smlaage/GewitterMonitor_v3/PCB/Antenna-Board/Front-View.png

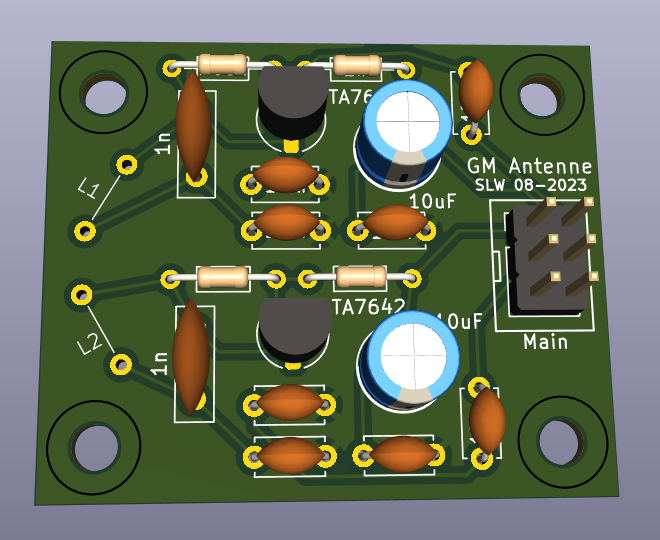
PCB/Antenna-Board/Front-View.png
