smlaage/GewitterMonitor_v3/GewitterMonitor_v3_Antenna_Schema.pdf

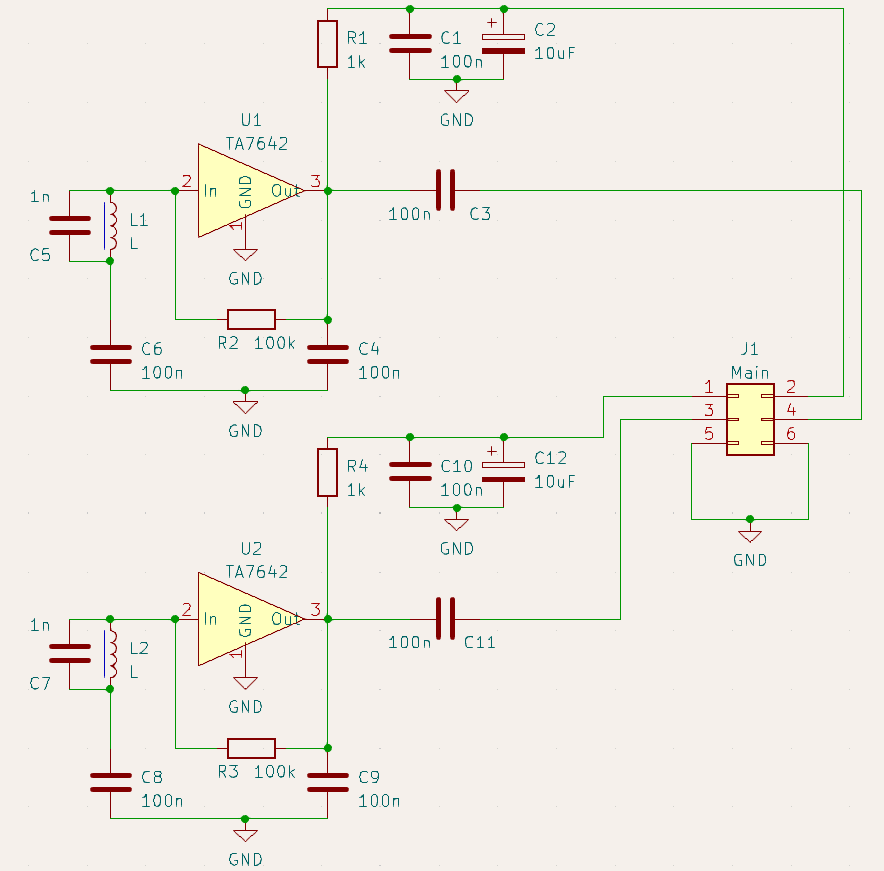
[picture p2: page 1]
