smlaage/GewitterMonitor_v3/PCB/Antenna-Board/Antenna-Module-1.png

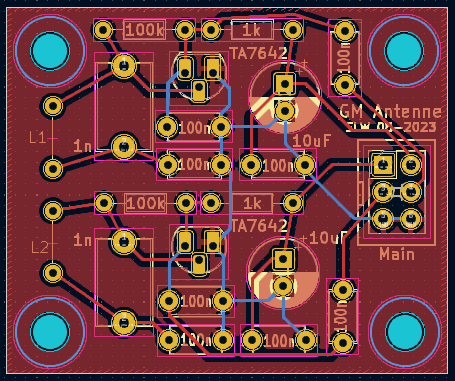
PCB/Antenna-Board/Antenna-Module-1.png
