smlaage/GewitterMonitor_v3/PCB/Antenna-Board/Antenna-Module-2.png

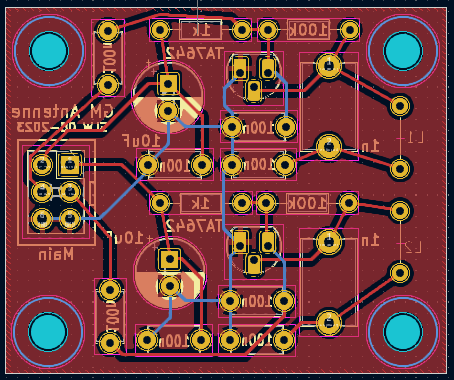
PCB/Antenna-Board/Antenna-Module-2.png
