smlaage/GewitterMonitor_v3/PCB/Main-Board/MainBoard-Back.png

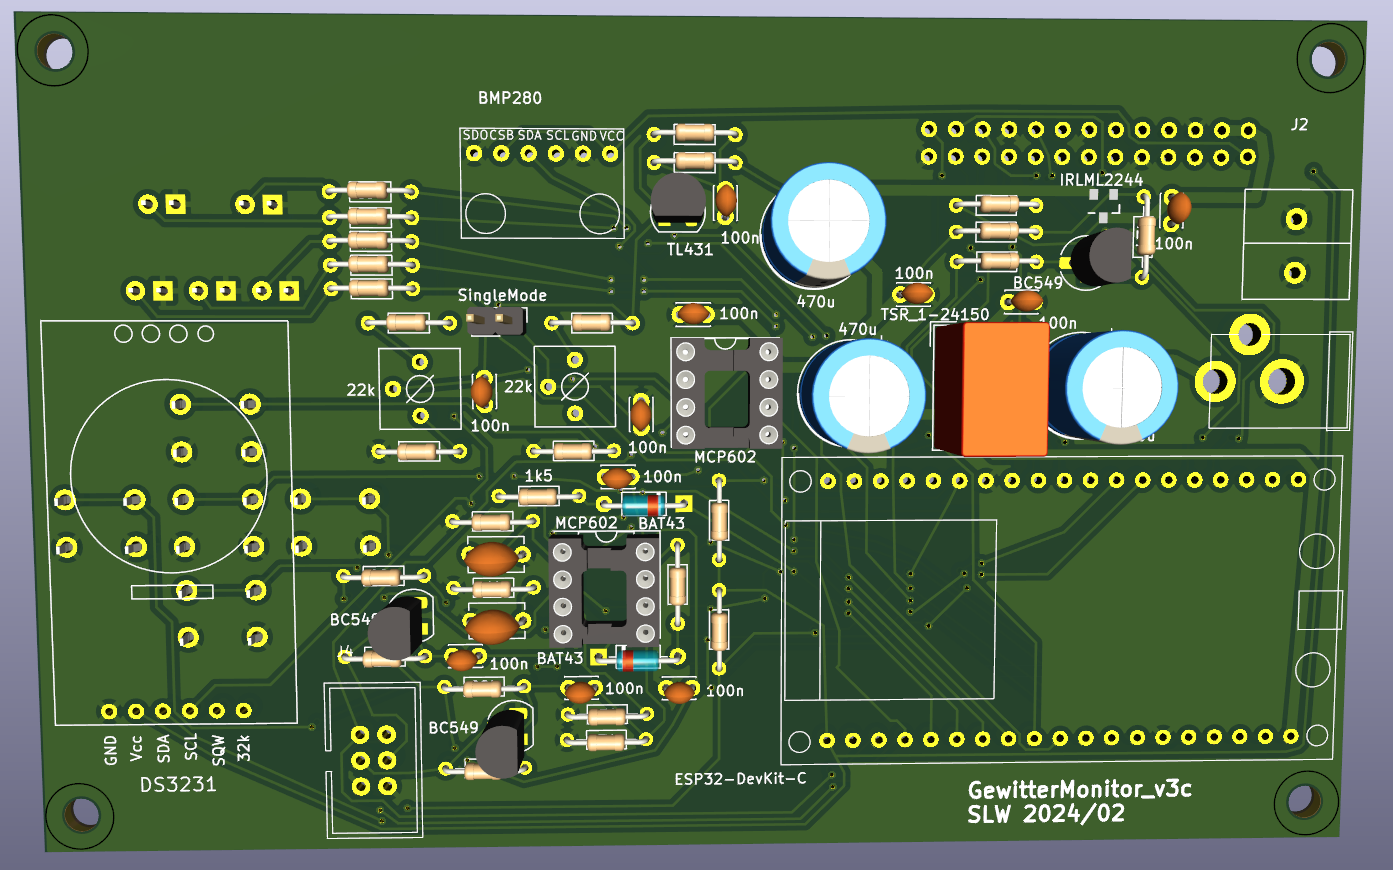
PCB/Main-Board/MainBoard-Back.png
