smlaage/GewitterMonitor_v3/PCB/Main-Board/MainBoard-Front.png

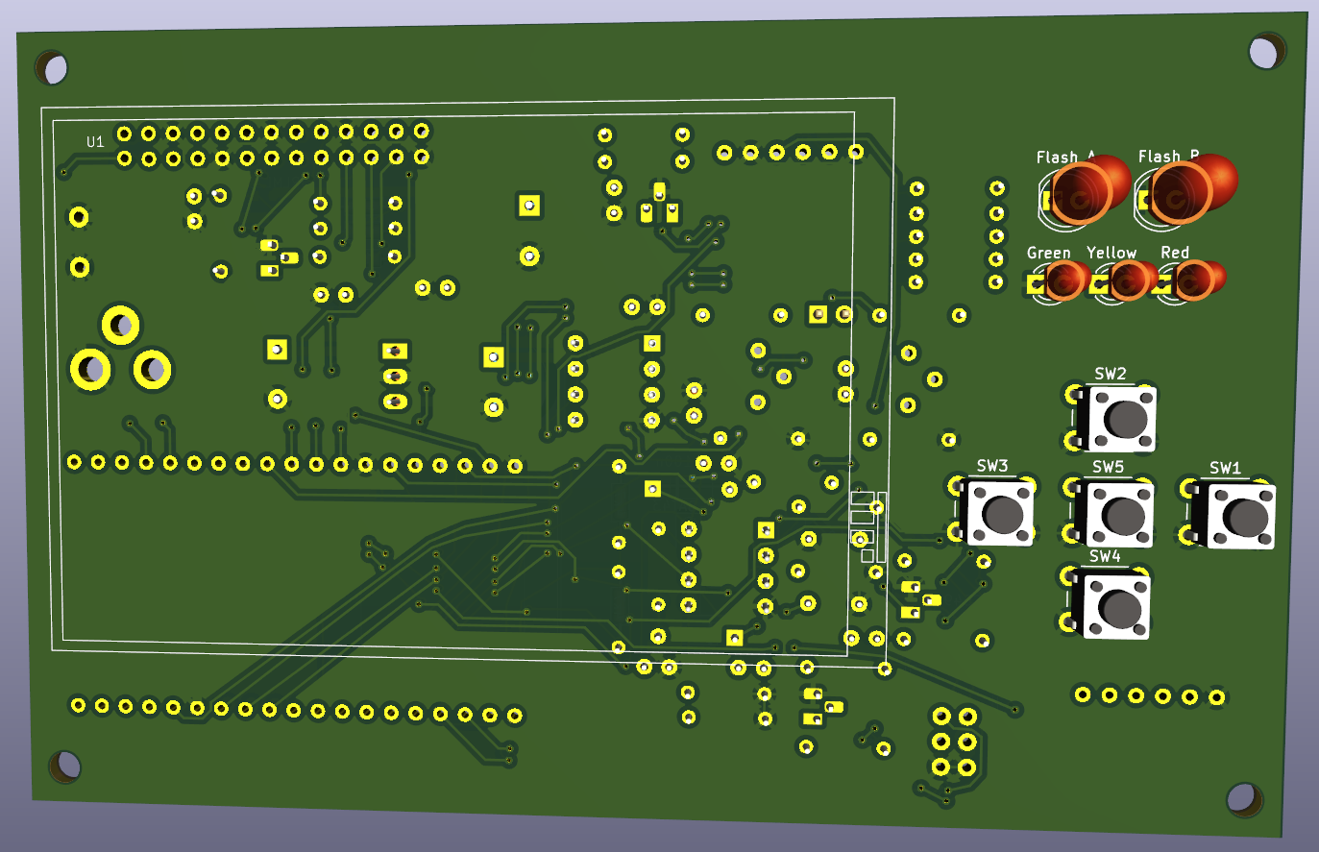
PCB/Main-Board/MainBoard-Front.png
