smlaage/GewitterMonitor_v3/3D-Printing/Standfuss.stl

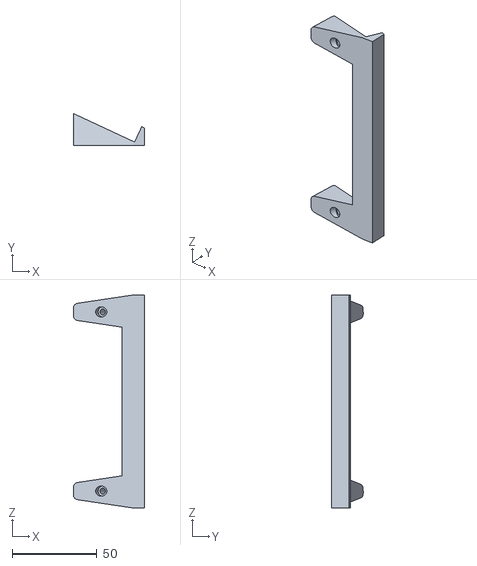
[picture p7: CAD file, 2024-04-09]
3D-Printing/Standfuss.stl
42.3 x 18.8 x 126.0
