smlaage/GewitterMonitor_v3/3D-Printing/LED-Abstandshalter.stl

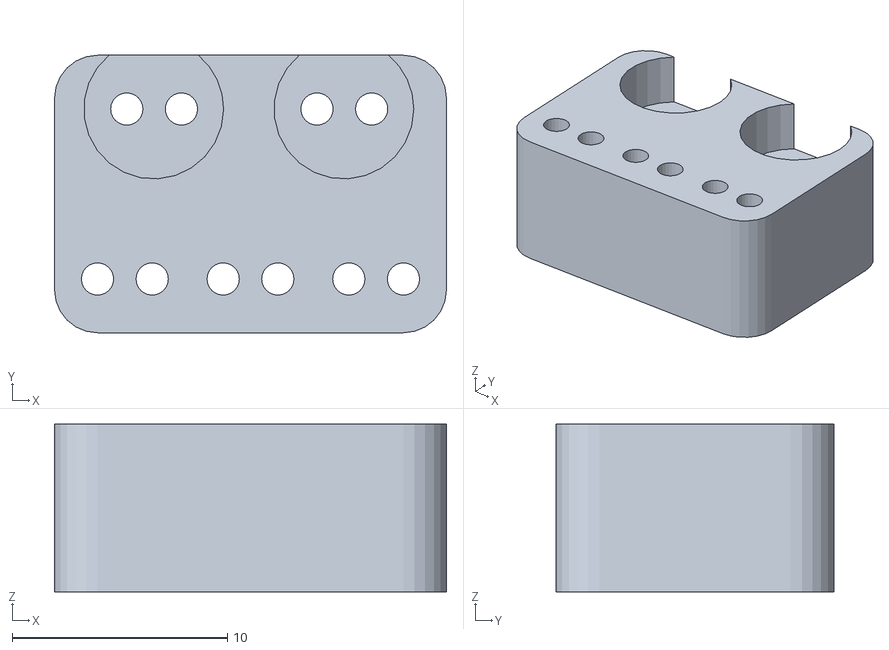
[picture p8: CAD file, 2024-04-09]
3D-Printing/LED-Abstandshalter.stl
18.2 x 12.9 x 7.80
