smlaage/GewitterMonitor_v3/3D-Printing/Antennenhalter.stl

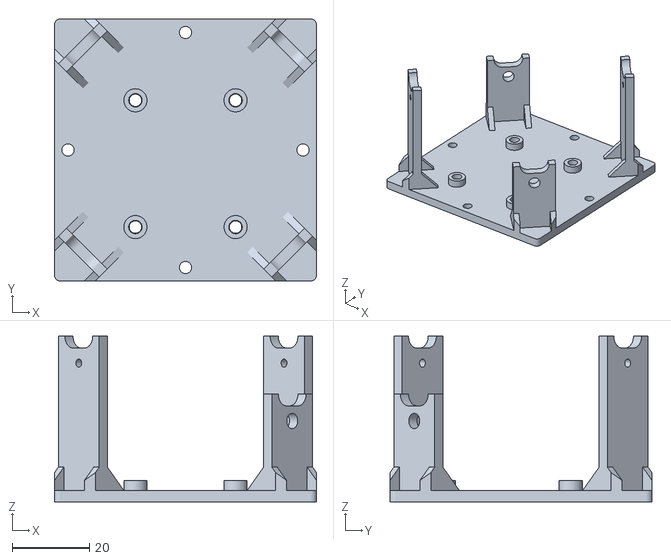
[picture p9: CAD file, 2023-09-27]
3D-Printing/Antennenhalter.stl
68.0 x 68.0 x 43.0
