smlaage/GewitterMonitor_v3/3D-Printing/Display-Spacer.stl

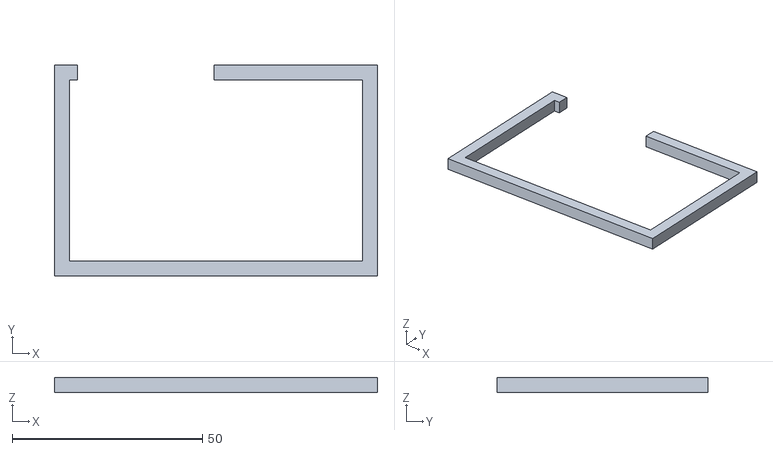
[picture p10: CAD file, 2023-09-27]
3D-Printing/Display-Spacer.stl
85.0 x 55.5 x 4.00
