smlaage/GewitterMonitor_v3/3D-Printing/Display-Rahmen.stl

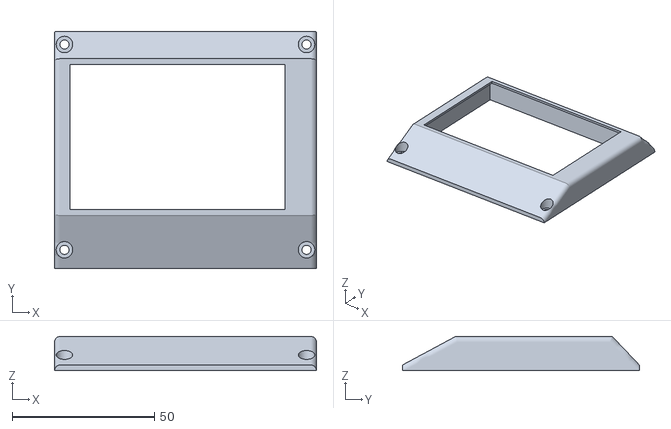
[picture p11: CAD file, 2023-09-27]
3D-Printing/Display-Rahmen.stl
92.0 x 83.1 x 12.0
