smlaage/GewitterMonitor_v3/3D-Printing/Frontplatte.stl

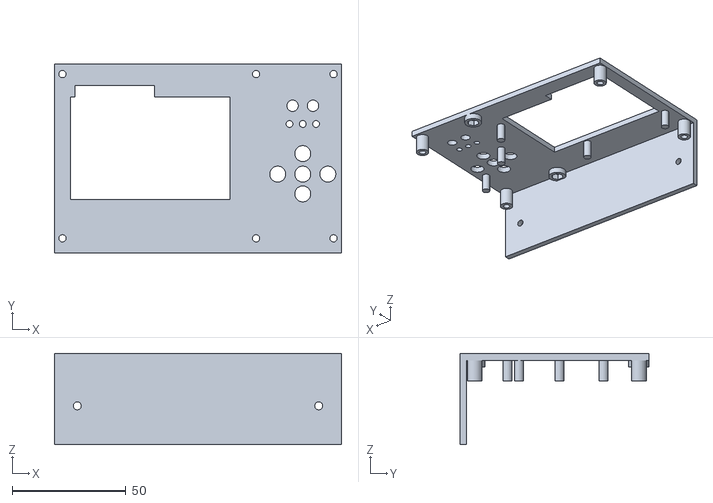
[picture p12: CAD file, 2023-09-27]
3D-Printing/Frontplatte.stl
126.0 x 83.1 x 40.0
