smlaage/GewitterMonitor_v3/GewitterMonitor_v3_Main_Schema.pdf

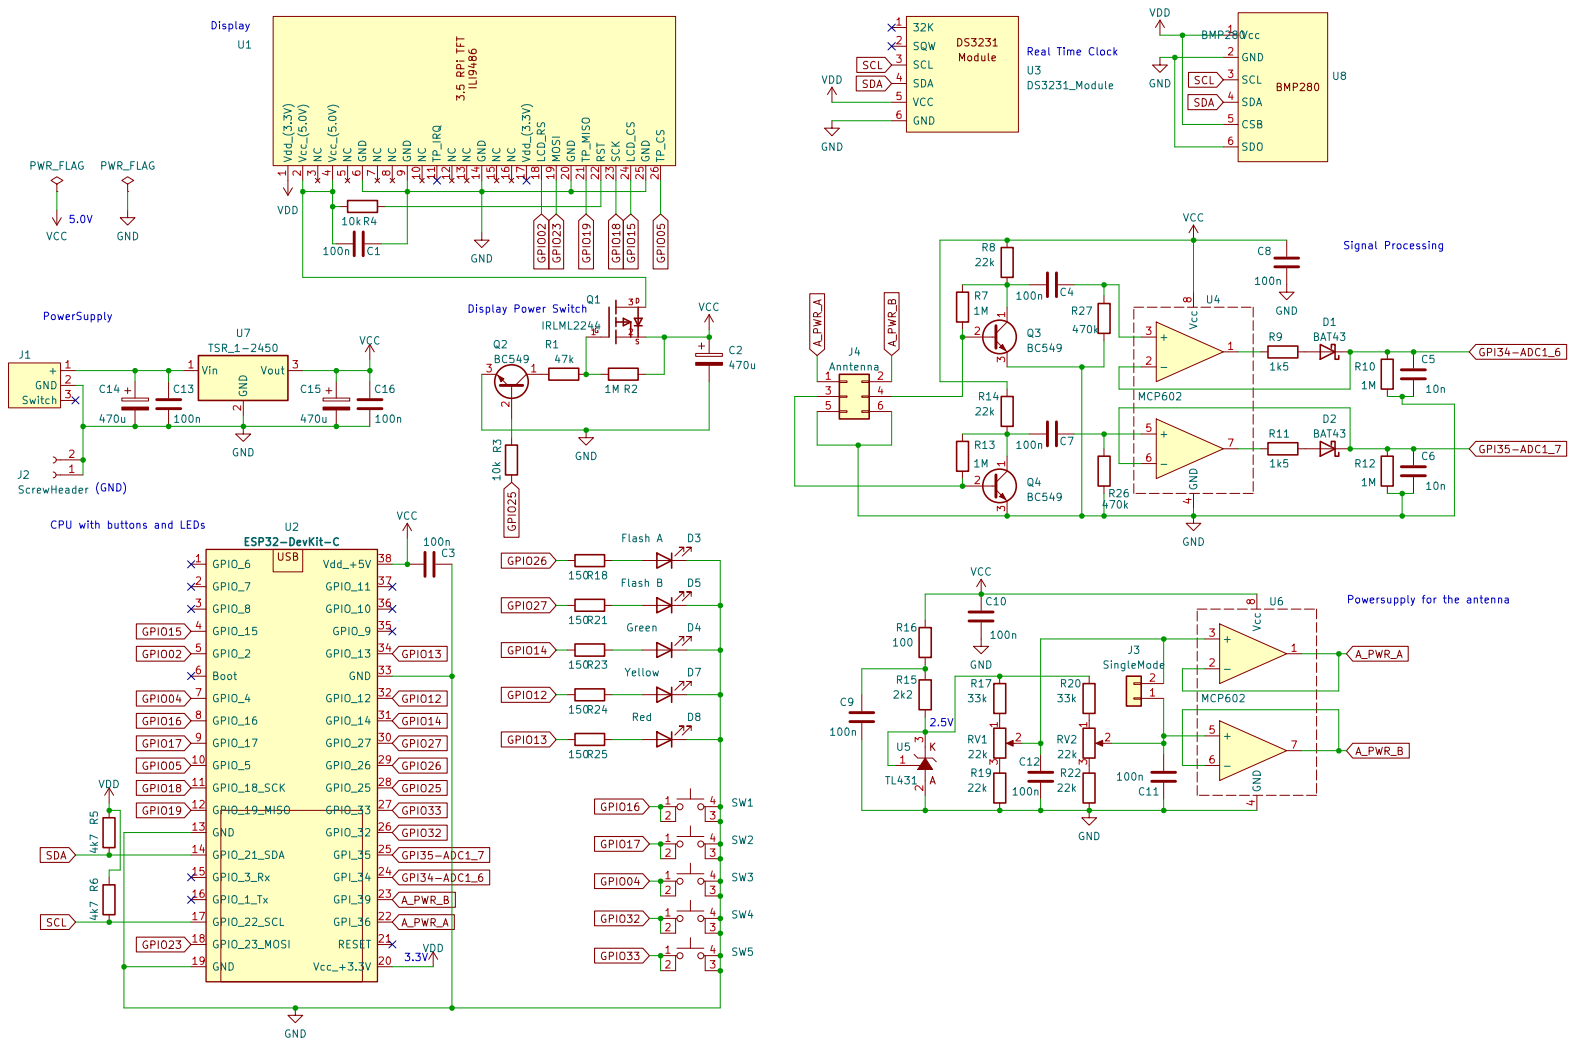
[picture p13: page 1]
