smlaage/GewitterMonitor_v3/(commit log)

2023-09-27 PCB files added
    [GewitterMonitor-B_Cu.gbr, GewitterMonitor-B_Mask.gbr, GewitterMonitor-B_Paste.gbr, GewitterMonitor-B_Silkscreen.gbr, GewitterMonitor-Edge_Cuts.gbr, GewitterMonitor-F_Cu.gbr, GewitterMonitor-F_Mask.gbr, GewitterMonitor-F_Paste.gbr]
2023-09-27 Stl files added
    [Antennenhalter.stl, Display-Rahmen.stl, Display-Spacer.stl, Frontplatte.stl]
2023-10-04 Software Updates
    [Frontplatte.3mf]
2024-02-15 Schemas and part list added
    [GewitterMonitor_v3_PartList.xlsx]
2024-04-18 Schema labels fixed
    [GewitterMonitor_v3_PartList.csv, GewitterMonitor_v3_PartList.xlsx]
2024-04-18 PCB labels fixed
    [GewitterMonitor-B_Mask.gbr, GewitterMonitor-B_Paste.gbr, GewitterMonitor-B_Silkscreen.gbr, GewitterMonitor-Edge_Cuts.gbr, GewitterMonitor-F_Cu.gbr, GewitterMonitor-F_Mask.gbr, GewitterMonitor-F_Paste.gbr, GewitterMonitor-F_Silkscreen.gbr]
2024-05-19 Bug fix: air pressure sensor data
    [display.cpp]
2024-07-21 New version 3.2
    Based on Espressif 3.0.2
    WLAN and MQTT connectivity added
    [mqtt_config.txt]
2024-07-21 PCB bug fixes
    [GewitterMonitor-B_Cu.gbr, GewitterMonitor-B_Mask.gbr, GewitterMonitor-B_Paste.gbr, GewitterMonitor-B_Silkscreen.gbr, GewitterMonitor-Edge_Cuts.gbr, GewitterMonitor-F_Cu.gbr, GewitterMonitor-F_Mask.gbr, GewitterMonitor-F_Paste.gbr]
2024-07-21 Minor updates
    [GewitterMonitor-job.gbrjob, GewitterMonitorAntenne-job.gbrjob]
2024-07-25 Minor bug fixes
    [mqtt_config.txt]
2024-07-25 ELF und BIN files uploaded
2024-07-26 List of Arduino dependencies added
2024-07-31 Raspberry Pi with MQTT and webserver added
2024-08-08 Sequence for network connection corrected
    [command_line.cpp, command_line.h, display.cpp, display.h, gewitter_monitor.h, keyboard.cpp, menu.cpp]
2026-06-25 Update Wire.begin() to specify SDA and SCL pins
    This seems to be necessary for the new version of the ESP32 Dev Kit v4.
2026-06-26 Fix condition for displaying scaled values
    [display.cpp]
